trmint195/zstick_dongle/hardware/case/case/3d print/case_dongle_zmk_0.5_2.stl

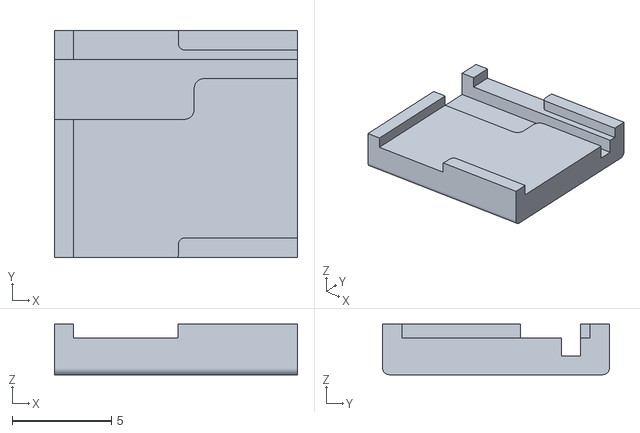
[picture p1: CAD file, 2026-10-13]
hardware/case/case/3d print/case_dongle_zmk_0.5_2.stl
12.3 x 11.4 x 2.55
