trmint195/zstick_dongle/hardware/case/case/zmk_dongle_v0.5.step

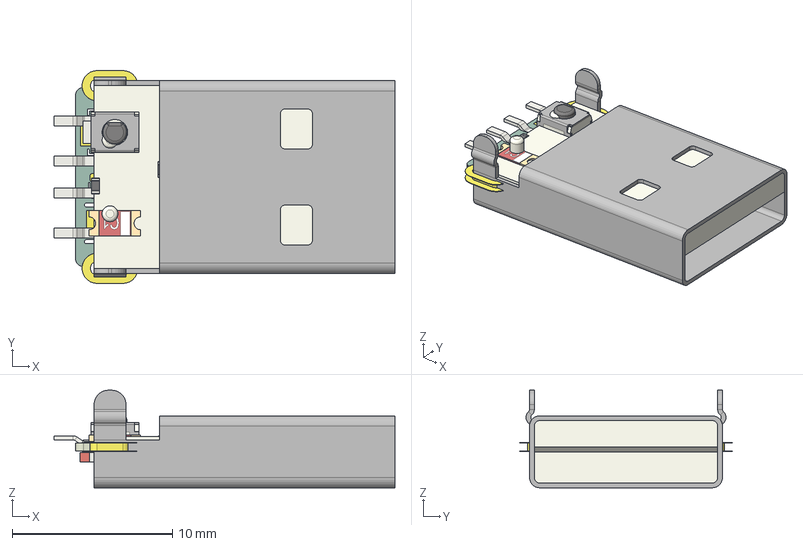
[picture p2: CAD file, 2026-10-13]
hardware/case/case/zmk_dongle_v0.5.step
21.3 x 13.3 x 6.10 mm
C_0402_1005Metric x 17
L_0402_1005Metric x 2
aQFN73 v2
R_0402_1005Metric x 3
L_0603_1608Metric x 2
CA-C01
SW_SPST_B3U-1000P
Crystal_SMD_SeikoEpson_FA238V-4Pin_3.2x2.5mm
LED_Kingbright_APA1606_1.6x0.6mm_Horizontal
USB_A_CNCTech_1001-011-01101_Horizontal
zmk_dongle_2.4ghz_copper
zmk_dongle_2.4ghz_silkscreen x 2
zmk_dongle_2.4ghz_soldermask x 2
zmk_dongle_2.4ghz_PCB
