trmint195/zstick_dongle/hardware/case/stencill_holder/stencill_holer-Body.stl

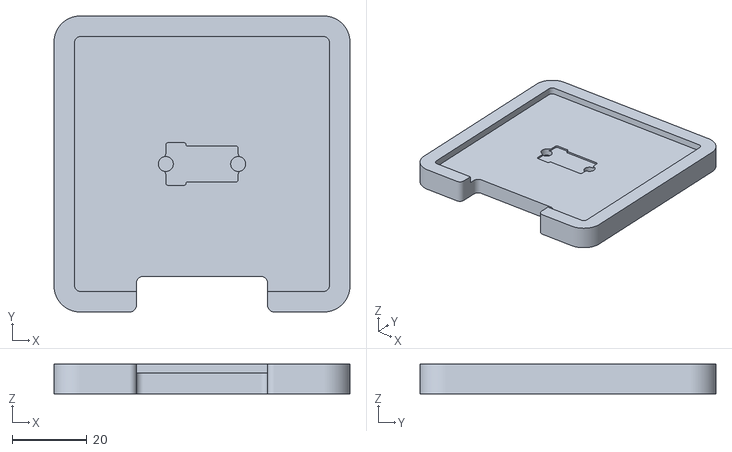
[picture p3: CAD file, 2026-10-13]
hardware/case/stencill_holder/stencill_holer-Body.stl
79.0 x 79.0 x 8.00
