trmint195/zstick_dongle/hardware/case/case/3d print/case_dongle_zmk_0.5_3.stl

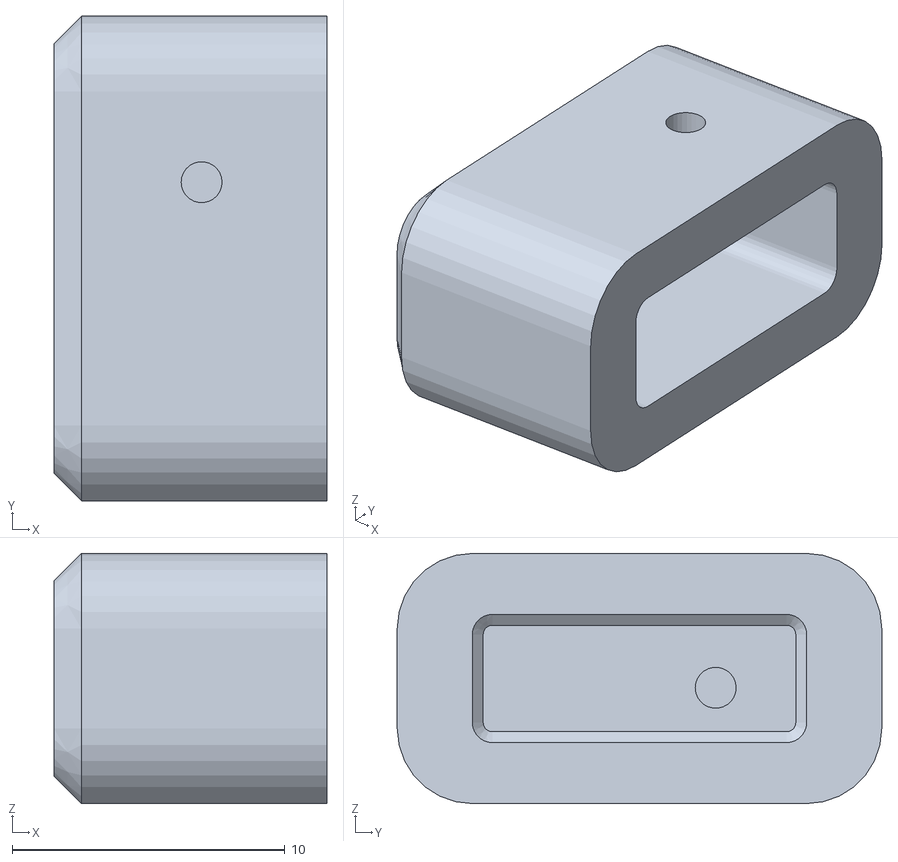
[picture p4: CAD file, 2026-10-13]
hardware/case/case/3d print/case_dongle_zmk_0.5_3.stl
10.0 x 17.8 x 9.16
