trmint195/zstick_dongle/hardware/case/case/case_dongle_zmk_v0.5.FCStd

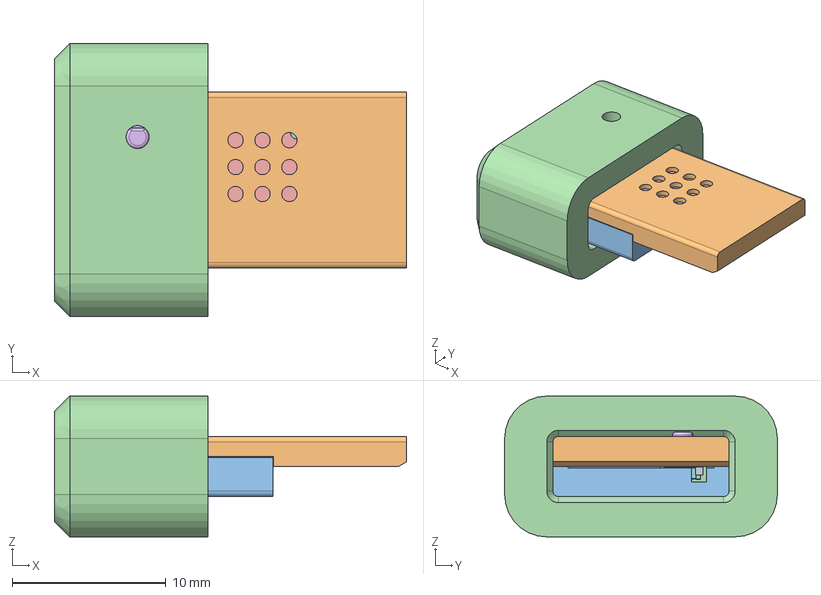
[picture p5: CAD file, 2026-10-13]
hardware/case/case/case_dongle_zmk_v0.5.FCStd
22.9 x 17.8 x 9.16 mm
C_0402_1005Metric
C_0402_1005Metric002
C_0402_1005Metric004
L_0402_1005Metric
aQFN73 v2
aQFN73 v001
aQFN73 v002
aQFN73 v003
aQFN73 v004
aQFN73 v005
aQFN73 v006
aQFN73 v007
aQFN73 v008
aQFN73 v009
aQFN73 v010
aQFN73 v011
aQFN73 v012
aQFN73 v013
aQFN73 v014
aQFN73 v015
aQFN73 v016
aQFN73 v017
aQFN73 v018
aQFN73 v019
aQFN73 v020
aQFN73 v021
aQFN73 v022
aQFN73 v023
aQFN73 v024
aQFN73 v025
aQFN73 v026
aQFN73 v027
aQFN73 v028
aQFN73 v029
aQFN73 v030
aQFN73 v031
aQFN73 v032
aQFN73 v033
aQFN73 v034
aQFN73 v035
aQFN73 v036
aQFN73 v037
aQFN73 v038
aQFN73 v039
aQFN73 v040
aQFN73 v041
aQFN73 v042
aQFN73 v043
aQFN73 v044
aQFN73 v045
aQFN73 v046
aQFN73 v047
aQFN73 v048
aQFN73 v049
aQFN73 v050
aQFN73 v051
aQFN73 v052
aQFN73 v053
aQFN73 v054
aQFN73 v055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
