trmint195/zstick_dongle/hardware/case/case/3d print/case_dongle_zmk_0.5_1.stl

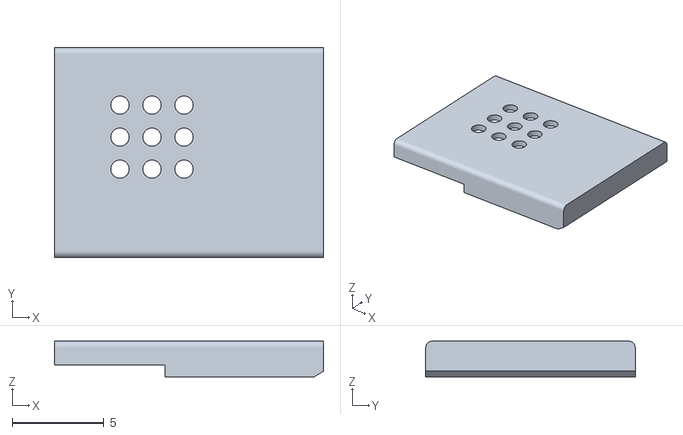
[picture p6: CAD file, 2026-10-13]
hardware/case/case/3d print/case_dongle_zmk_0.5_1.stl
14.7 x 11.4 x 1.95
