trmint195/zstick_dongle/(list of files, cad)

Other CAD files:
hardware/case/stencill_holder/stencill_holer.FCStd
