trmint195/zstick_dongle/hardware/zmk_dongle_2.4ghz.kicad_pcb

## KiCad design hardware/zmk_dongle_2.4ghz.kicad_pcb (2026-10-13)

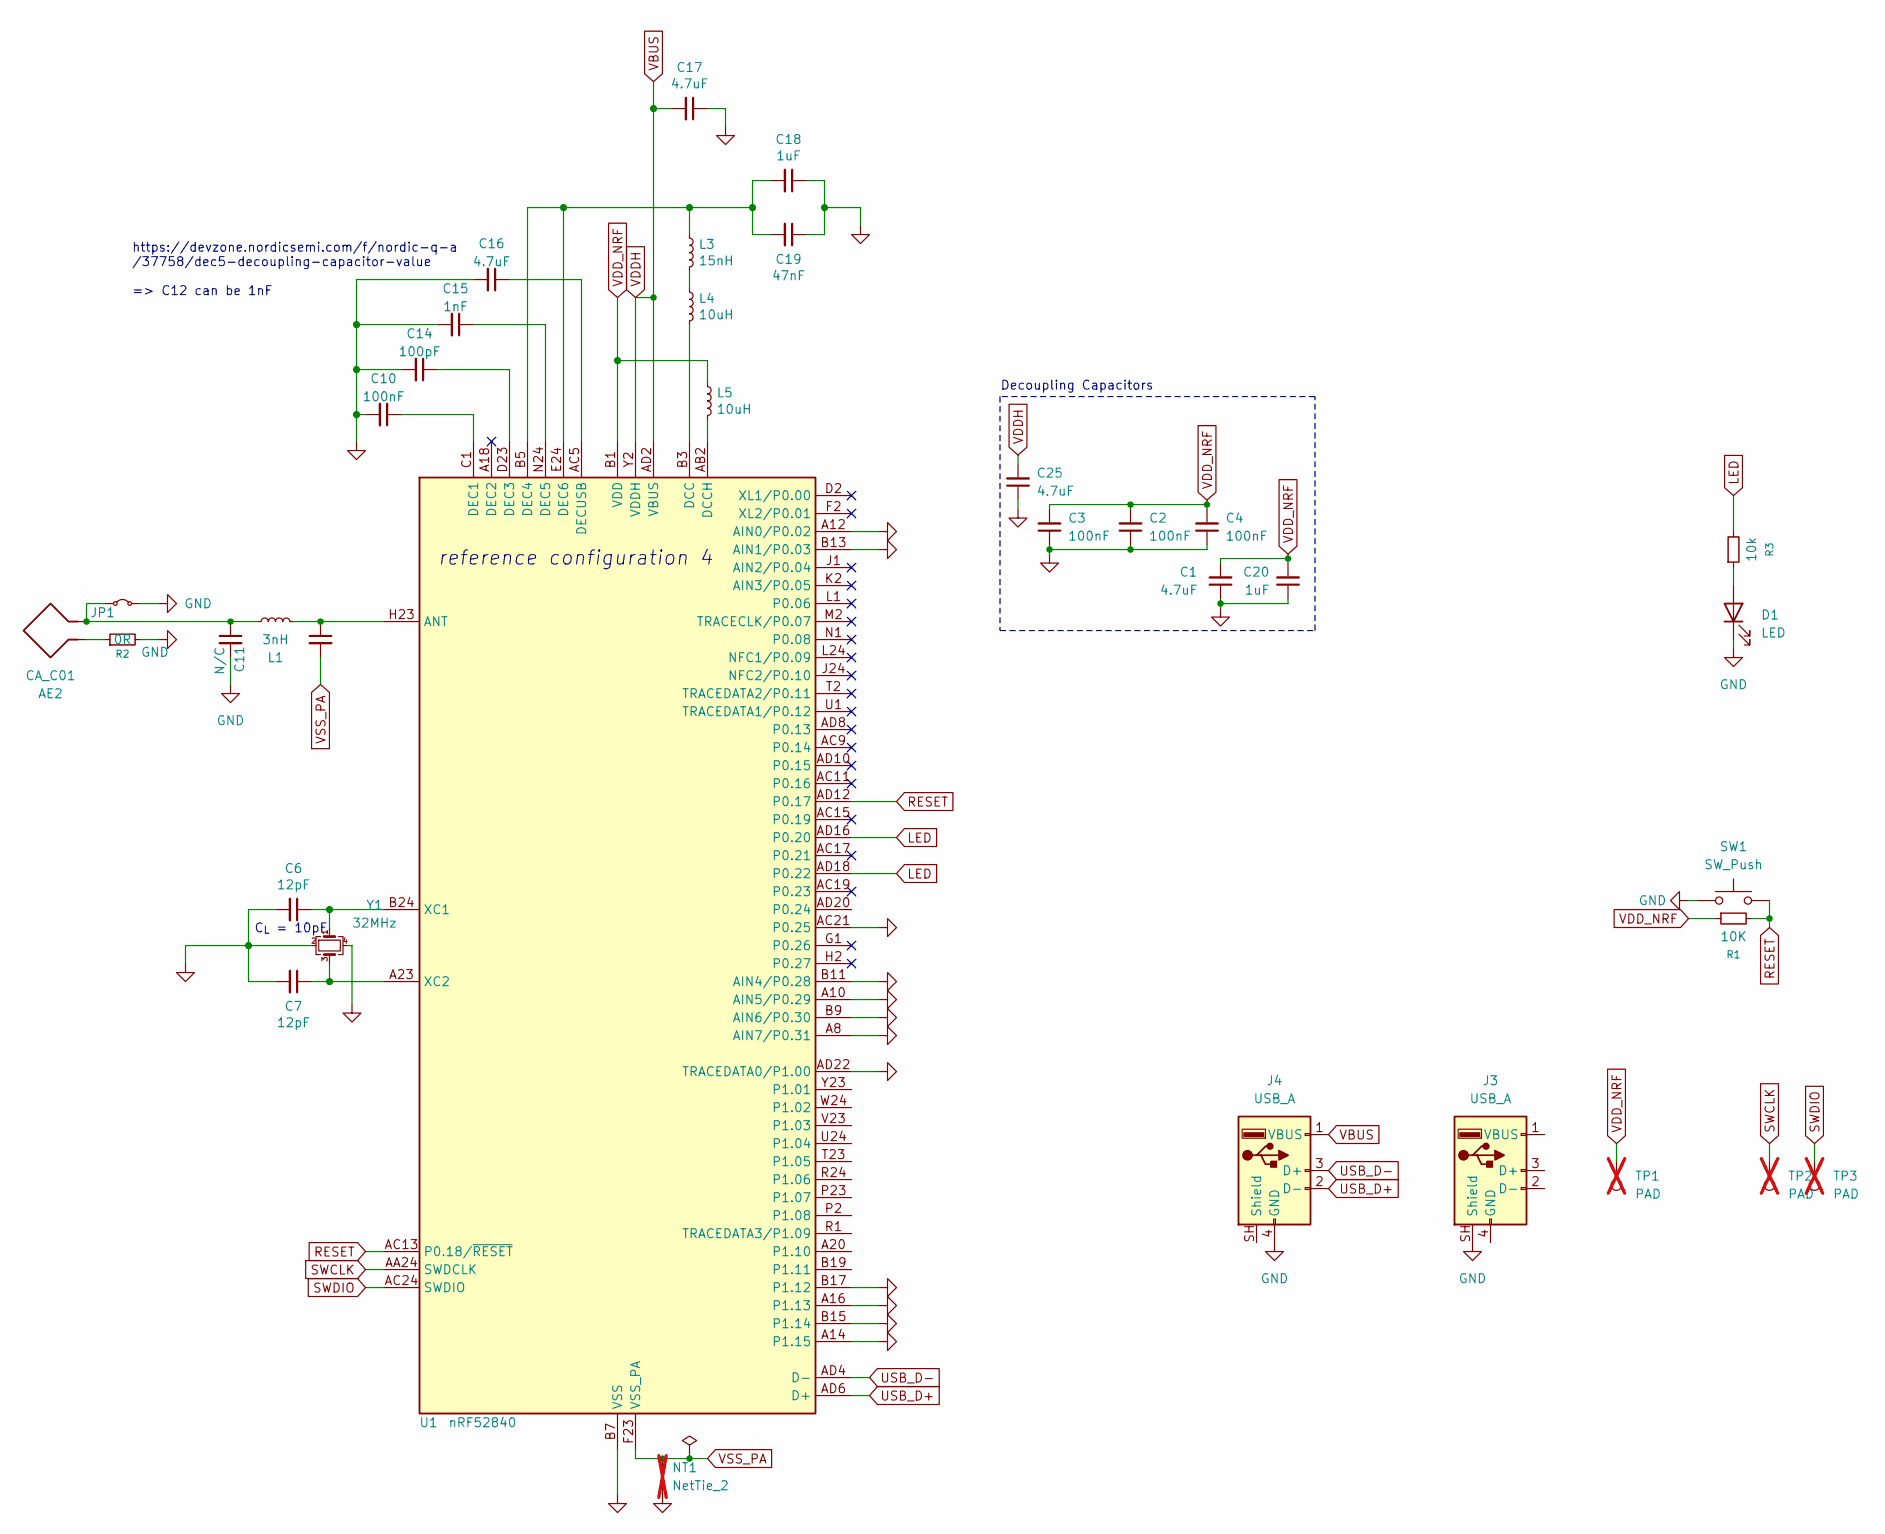
[picture p7: schematic zmk_dongle_2.4ghz.kicad_sch]

Parts:
AE2: CA_C01; CA-C01
C1, C16, C17, C25: 4.7uF; C_0402_1005Metric; Manufacturer Part CL05A475KP5NRNC; LCSC Part C368809
C2, C3, C4, C10: 100nF; C_0402_1005Metric; Manufacturer Part CL05B104KA5NNNC; LCSC Part C307331
C6, C7: 12pF; C_0402_1005Metric; Manufacturer Part CL05C150JB51PNC; LCSC Part C1548
C8, C11: N/C; C_0402_1005Metric
C14: 100pF; C_0402_1005Metric; Manufacturer Part CL05C101JB5NNNC; LCSC Part C1546
C15: 1nF; C_0402_1005Metric; Manufacturer Part CL05B102KB5NNNC; LCSC Part C1523
C18, C20: 1uF; C_0402_1005Metric; Manufacturer Part CL05A105KO5NNNC; LCSC Part C52923
C19: 47nF; C_0402_1005Metric; Manufacturer Part CL05B473KO5NNNC; LCSC Part C726525
D1: LED; LED_Kingbright_APA1606_1.6x0.6mm_Horizontal
J3: USB_A; USB_A_CNCTech_1001-011-01101_Horizontal
J4: USB_A; USB_A_PCB_Connect
JP1: net-tie-2-tiny
L1: 3nH; L_0402_1005Metric
L3: 15nH; L_0402_1005Metric; Manufacturer Part MLG1005S15NJT000; LCSC Part C27143
L4, L5: 10uH; Inductor_0603_1608M-nosilk; Manufacturer Part MLF1608E100KTD00; LCSC Part C1035
NT1: NetTie_2; net-tie-2-tiny-longer; not fitted
R1: 10K; R_0402_1005Metric
R2: 0R; R_0402_1005Metric
R3: 10k; R_0402_1005Metric
SW1: SW_Push; SW_SPST_B3U-1000P
TP1, TP2, TP3: PAD; TestPoint_Pad_D1.0mm; not fitted
U1: nRF52840; AQFN-73-1EP_7x7mm_P0.5mm_NRF52840-custom; Manufacturer Part NRF52840-QIAA-R; LCSC Part C190794
Y1: 32MHz; Crystal_SMD_2016-4Pin_2.0x1.6mm; Manufacturer Part Q22FA1280001800; LCSC Part C255896

Connections:
GND: C1.1, C2.1, C3.1, C4.1, C6.2, C7.2, C10.2, C11.2, C14.2, C15.2, C16.2, C17.1, C18.1, C19.1, C20.1, C25.1, D1.1 (K), J3.SH (Shield_SH), J4.4 (GND), JP1.2 (B), NT1.2, R2.2, SW1.1, U1.A8 (AIN7/P0.31), U1.A10 (AIN5/P0.29), U1.A12 (AIN0/P0.02), U1.A14 (P1.15), U1.A16 (P1.13), U1.AC21 (P0.25), U1.AD22 (TRACEDATA0/P1.00), U1.B7 (VSS), U1.B9 (AIN6/P0.30), U1.B11 (AIN4/P0.28), U1.B13 (AIN1/P0.03), U1.B15 (P1.14), U1.B17 (P1.12), U1.EP (VSS), Y1.2, Y1.4
LED: R3.2, U1.AD16 (P0.20), U1.AD18 (P0.22)
unnamed: AE2.2, R2.1
unnamed: D1.2 (A), R3.1
unnamed: AE2.1, C11.1, JP1.1 (A), L1.2
unnamed: L3.2, L4.1
unnamed: C8.1, L1.1, U1.H23 (ANT)
unnamed: L4.2, U1.B3 (DCC)
unnamed: L5.2, U1.AB2 (DCCH)
unnamed: C10.1, U1.C1 (DEC1)
unnamed: C14.1, U1.D23 (DEC3)
unnamed: C18.2, C19.2, L3.1, U1.B5 (DEC4), U1.E24 (DEC6)
unnamed: C15.1, U1.N24 (DEC5)
unnamed: C16.1, U1.AC5 (DECUSB)
unnamed: C6.1, U1.B24 (XC1), Y1.1
unnamed: C7.1, U1.A23 (XC2), Y1.3
RESET: R1.2, SW1.2, U1.AC13 (P0.18/~RESET), U1.AD12 (P0.17)
SWCLK: TP2.1 (1_1), U1.AA24 (SWDCLK)
SWDIO: TP3.1 (1_1), U1.AC24 (SWDIO)
USB_D+: J4.2 (D-), U1.AD6 (D+)
USB_D-: J4.3 (D+), U1.AD4 (D-)
VBUS: C17.2, C25.2, J4.1 (VBUS), U1.AD2 (VBUS), U1.Y2 (VDDH)
VDD_NRF: C1.2, C2.2, C3.2, C4.2, C20.2, L5.1, R1.1, TP1.1 (1_1), U1.A22 (VDD), U1.AD14 (VDD), U1.AD23 (VDD), U1.B1 (VDD), U1.W1 (VDD)
VSS_PA: C8.2, NT1.1, U1.F23 (VSS_PA)

Notes on the sheet:
reference configuration 4
Decoupling Capacitors
C_{L} = 10pF
https://devzone.nordicsemi.com/f/nordic-q-a /37758/dec5-decoupling-capacitor-value => C12 can be 1nF

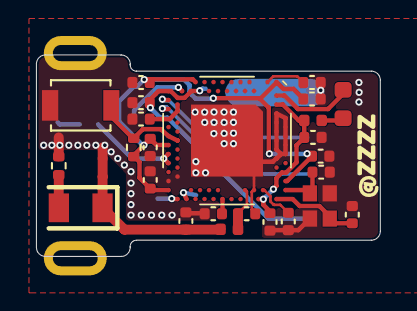
[picture p8: board zmk_dongle_2.4ghz.kicad_pcb from above]

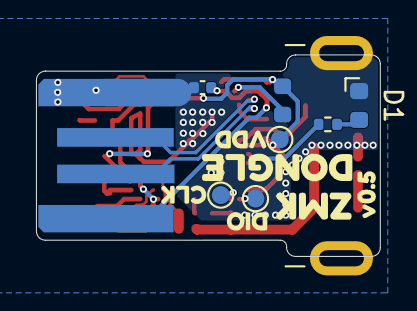
[picture p9: board zmk_dongle_2.4ghz.kicad_pcb from below]

Board: 2 copper layers, 19.1 x 11.2 mm, 43 parts (15 on the bottom side), 24 nets.

Other parts of the board:
kibuzzard-6AB69C4B: G***; kibuzzard-6AB69C4B
kibuzzard-6AB69C5E: G***; kibuzzard-6AB69C5E
kibuzzard-6AC6E950: G***; kibuzzard-6AC6E950
kibuzzard-6AC45A7D: G***; kibuzzard-6AC45A7D
kibuzzard-6AC65E3A: G***; kibuzzard-6AC65E3A
kibuzzard-6AC65E7A: G***; kibuzzard-6AC65E7A
kibuzzard-6AC65E65: G***; kibuzzard-6AC65E65
